JDanison/Block-P-Neon-Sign/Software/Images/Background/OregonBlockP.JPG

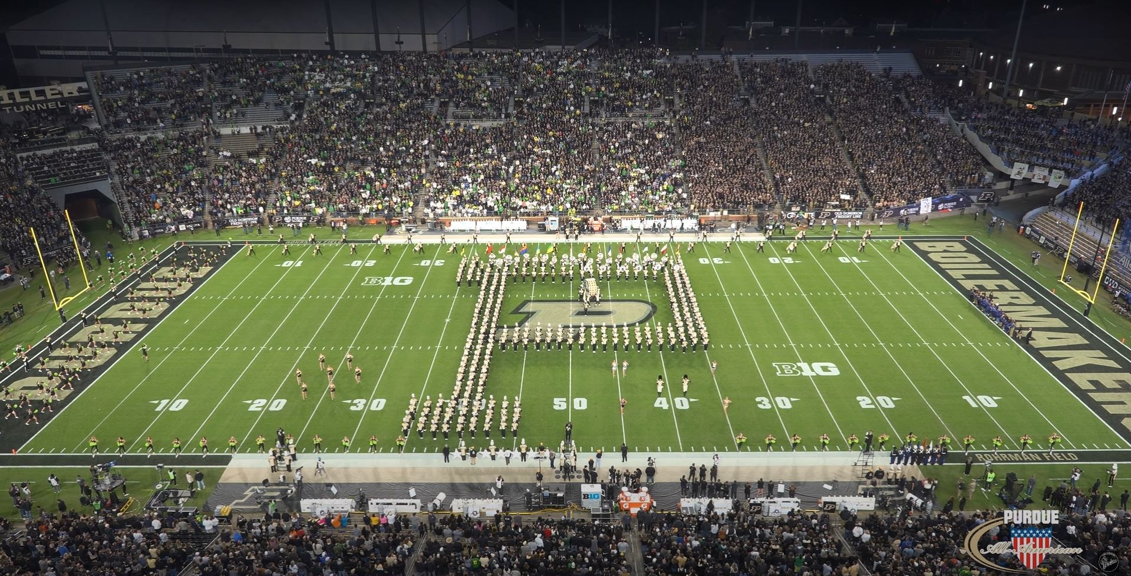
Software/Images/Background/OregonBlockP.JPG
