JDanison/Block-P-Neon-Sign/Hardware/CAD/block_p_viewer.html

# Block P CAD

The 8" build for the Bambu H2C, about 15.1 × 12.7 × 2.2 in. Pick Build guide above the model to see the assembly order. The LED strip is modeled as a standard 10 mm WS2812B until you confirm yours, and some other sizes are estimates until your parts arrive. Drag to rotate, scroll or use + and − to zoom, and right-drag to move.

Explore model Build guide: 12 steps

Loading the model…

Back Next

View

Zoom+−

LEDsOnOff

Explode Cut through depth

Show

## How the LEDs get power

Power reaches the strip at the inside corner where the stem meets the band under the screen. That corner has two 6 mm wire holes, and the bare wall there stays free of LEDs. Use the LED power view to see it from behind.

Hole | Wires | Goes to
Band side, 5 mm right of the corner | 5V, ground and data | Start of the strip, running right along the underside of the band
Stem side, 5 mm below the corner | 5V and ground only | Far end of the strip, after it has gone all the way around

Both ends get power so the far LEDs stay bright. The data wire connects only at the start. In the viewer, red is 5V, black is ground, green is data and orange is 12V.

## How the screen connects

The panel is 194 × 119 × 5 mm, and 11 mm with its rear circuit board. It sits rotated 180°, so its HDMI and power ports face down toward the Pi. Use the Screen wiring view to see it from behind.

Screen port | Cable | Comes from
HDMI | Flat HDMI ribbon | The Pi's micro-HDMI port beside the USB-C port (HDMI 0)
Power USB-C | USB-C power lead | The 5V junction
Touch USB-C | 1 ft right-angle USB cable | The Pi's upper USB 2.0 port

The speaker and button headers, audio jack and backlight switch stay unused. The picture and touch are rotated in software on the Pi.

## Wire bend check

Every corner in the model is a true arc, built at that cable's minimum bend radius. Route ends leave their connectors straight, then turn.

Route | Cable | Minimum (mm) | Tightest (mm) | Length (mm) | Status

## Parts to print

File | Filament | Size (mm) | Job
shell_upper | Black | 321 × 252 × 55 | Top of the sign, screen window, speaker pockets, vents
shell_lower | Black | 113 × 139 × 55 | Lower stem and foot, power jack
diffuser_upper | Translucent white | 321 × 252 × 17 | Glowing outline, glued over the LED channel
diffuser_lower | Translucent white | 113 × 139 × 17 | Same, for the lower section
cover_upper | Black | 315 × 275 × 24 | Back panel, wall keyholes, Pi and board mounts
cover_lower | Black | 107 × 109 × 8 | Back panel for the stem and foot
4 screen_clip files | Black | 33 × 16 × 4 | Hold the screen by its corners, leaving the cable paths open
stem_splice | Black | 25 × 40 × 4 | Joins the two shell sections inside the stem
audio_strap | Black | 48 × 12 × 3 | Holds the USB dongle in its cradle
pi_bracket_left, pi_bracket_low, pi_bracket_high | Black | 3 mm thick | Hold the Pi case by its top screw positions

Every piece fits the H2C, but the two upper sections are 321 mm wide, so print those on the left nozzle only, where the bed is 325 mm wide. The print files are already laid flat, and the whole sign uses up to about 910 g of filament at full infill, so far less at normal settings. Print the three test pieces in print/test_pieces first to check the diffuser fit, glow and screw hole size. For the smoothest face, print the shells face down on a smooth PEI plate.

## How it goes together

1. Cut the strip into 12 sections, one for each straight wall, and stick them to the channel wall. Solder short 3-wire jumpers across the 11 corners, following the arrows on the strip. The two ends finish at the wire holes beside the stem.
2. Join the shell sections with the stem splice and 4 M3 screws, and glue on the diffusers.
3. Hook each speaker's two front tabs under the pads, drivers facing the grille, then lower it onto the two rear posts and fit 2 M3 × 12 mm screws. Run a screwdriver in along the inside with the cover off. Do this before fitting the screen.
4. Set the screen in from behind, rotated 180° so its ports face down, and screw on the 4 corner clips. The picture is flipped back in software.
5. Assemble the Pi in its case, using the kit's extra brass spacers on top. Set it in its corner stops on the upper cover and fit the three brackets. Add the converter and level shifter. Set the USB dongle in its cradle, screw the strap over it, and connect it to the Pi with its short USB cable. Then route and zip-tie the wires.
6. Fit the power jack through the foot, connect everything and test it.
7. Screw on both covers. The upper cover bridges the shell joint for strength.
8. Hang it on 2 wall screws, 201 mm apart, using the keyholes.

## How it's designed

- Power cord: It enters through the bottom of the foot and hangs straight down the wall.
- Wires: They run up the stem, then along a channel above the speakers, behind the screen. Each route is checked as a 3 mm bundle.
- Speakers: Two rear screws and two front hooks hold each one. The grille sits about 9 mm below the speaker face, and a 16 mm gap between the speakers gives their cables room.
- Raspberry Pi: The N300 case has no mounting holes underneath, so three printed brackets hold it from its top spacers, with corner stops around the case. Its fins face the back cover vents.
- USB dongle: It has no mounting holes, so a low cradle and screwed strap hold it, with its 4-pin header facing the speakers.
- LEDs: 68 LEDs sit on the outer wall of a 10 mm deep channel, facing out, about 6 mm behind the diffuser. Each corner has room for a soldered jumper.
- Cooling: Cool air enters low, through the bottom of the foot, the stem walls, the underside and the lower right wall. It rises past the electronics and leaves through the top wall and upper side walls, so the airflow doesn't depend on the gap behind the sign.
- Servicing: The covers come off with screws, so the wiring stays reachable. The diffusers are glued on.

## Send when parts arrive

- Screen: exact port positions on the rear board. They're scaled from a photo
- Speakers, which you already have: length, width, thickness, tab hole size and spacing, and how far the tabs sit from the face
- Converter: length, width, thickness and mounting holes
- USB dongle, which you already have: total length, body length, width and thickness
- Power jack: hole size and thread
- LED strip: width, LEDs per meter, total length and thickness
- Pi in its case: length, width, thickness and top-of-USB height

## Small hardware

- 44 M3 × 10 mm self-tapping screws, the only screw size in the sign
- 10 small zip ties, 3.6 mm wide or narrower, for the 10 clips on the back cover
- 2 wall screws with heads under 9 mm, shafts under 5 mm
- Thin wire for 33 corner jumper wires, 3 at each of 11 corners. Stranded 24 AWG or thinner bends best, and the tight corner under the top-left notch needs 28 AWG
- 4 stick-on rubber bumpers, about 8 mm tall, to hold the back off the wall
- CA glue for the diffusers, plus thin foam tape for the dongle strap

## Files

All files are in Hardware/CAD in your project folder.

- print/black and print/white: STL files for Bambu Studio, sorted by filament color and already flat on the bed. print/PRINT_LIST.md lists every file
- step: exact CAD files for each part and the full assembly
- block_p_assembly_preview.stl: the whole assembled sign, for other model viewers
- block_p.py: the model itself. Every size is a named number at the top
