JDanison/Block-P-Neon-Sign/Design Process/Renders/block-p-renders.html

# Block P sign

All three sizes use your locked shape at true scale. Drag to rotate, scroll or pinch to zoom.

Loading the 3D model…

View

AngleFrontSideBelow

Zoom+−

LEDsGoldOff

RoomDimLit

PrintBlackWhite

Select 5", 7" or 8" to see that option's details, wiring and parts.

## Parts to buy

Part | Spec | Notes

## Power wiring

One cord comes in at 12V, and the converter inside the sign makes a steady 5V. The Pi and the LEDs each take their own branch, so the LEDs never draw through the Pi.

### Bring-up order

1. Check that the adapter is center positive, then connect the jack and converter.
2. Measure the converter output with nothing else connected. Expect about 5.0 to 5.25V.
3. Solder the 5V junction and the Pi's USB-C lead, then boot the Pi.
5. Play a video and run vcgencmd get_throttled. A result of 0x0 means no low-voltage events.
6. Add the strip's power at both ends and the capacitor, then the level shifter, resistor and data line.
7. Run everything together for a few hours before it goes in the enclosure.

### Estimated power, gold LEDs

Load | Amps at 5V | Basis

Audio assumes the board's 2.6W into 4Ω rating drops by about half with your 8Ω speakers. The LED figure uses the strip seller's 5V 3A per meter at gold brightness.

### Get back to this page

Open it from the pinned list in your claude.ai sidebar, or from /artifacts in Claude Code. The link and a saved copy are listed in PROGRESS.md in the project folder.
