JDanison/Block-P-Neon-Sign/Hardware/BOM.md

# Block P Sign: Bill of Materials

For the locked Block P shape with the 8" screen: about 15.4 x 12.6 x 2.2 in, black print, your own WS2812B strip (about 1.3 m in 12 sections).

Only the screen's details come from the maker. Other details are seller listings, so check each listing before buying.

## Buy

| Part | Spec | Notes |
|---|---|---|
| [Waveshare 8DP-CAPLCD 8" screen](https://www.amazon.com/dp/B0BPMCTQQ8) | 1280 x 800 HDMI | Includes HDMI, USB, micro-HDMI adapter and spacers |
| [Meiyue 12V 5A adapter](https://www.amazon.com/dp/B0BPSQ84TT) | 60W, 5.5 x 2.1 mm plug | About 5 ft cord. Check it is center positive |
| [Tugermoola barrel jacks, 6 sets](https://www.amazon.com/dp/B0DP6MNQQB) | 5.5 x 2.1 mm, panel mount | Uses 1 |
| [KNACRO 12V to 5V converter](https://www.amazon.com/dp/B07D268SDY) | 10A, 50W | Size the mount from the real part |
| [Vovucai USB-C power leads, 5 pack](https://www.amazon.com/dp/B0F31YX6XX) | 22 AWG, 5V 3A | Uses 2. Cut to about 30 cm |
| [SN74AHCT125N, 5 pack](https://www.amazon.com/dp/B08FHD994N) | 3.3V to 5V level shifter | Skip if you have one |
| [chenyang flat HDMI to micro-HDMI cable](https://www.amazon.com/dp/B01367WEI4) | 0.2 m, 90 degree up | Buy after CAD confirms the direction |
| [SUNGUY right angle USB-A to C cables, 2 pack, 1 ft](https://www.amazon.com/dp/B0784F9JP2) | 1 ft, supports data | For touch. The 6 in version does not reach |
| [Geekworm N300 heatsink case](https://www.amazon.com/dp/B07X5Y81C6) | 16 mm thick, for Pi 4 | Cools the Pi with no fan |
| [Glvaner M3 x 10 mm self-tapping screws, 100 pack](https://www.amazon.com/dp/B09NPL4P9W) | 304 stainless steel, pan washer head | Uses 44 |
| [PATIKIL perfboard, 24 pack](https://www.amazon.com/dp/B0CBPRBRTT) | 1.2 x 1.2 in | Holds the level shifter |
| [eSUN Lithophane White PLA+, 1 kg](https://www.amazon.com/dp/B0D7PZS1VV) | LED diffuser | Translucent white. Test with your strip first |

## Optional

| Part | Spec | Notes |
|---|---|---|
| [YUNPICAR fuse holders, 2 pack](https://www.amazon.com/dp/B09539L14T) | 18 AWG, with 5A mini blade fuses | LED branch, recommended |
| [Fancasee DC extension cord](https://www.amazon.com/dp/B09SZ88S1Y) | 6 ft, 18 AWG, 5.5 x 2.1 mm | If the 5 ft cord falls short. Check that it is rated for 3A or more |
| [FCOB WS2812B strip, 6.56 ft](https://www.amazon.com/dp/B0FL7GKGVM) | 5V, 160 LEDs/m, 5 mm wide | Only if your own strip is too short. The CAD would need updating |

## Small hardware

Needed for the current CAD model, if you don't already have them.

- 10 small zip ties, 3.6 mm wide or narrower
- 2 wall screws with heads under 9 mm and shafts under 5 mm
- 4 stick-on rubber bumpers, about 8 mm tall
- CA glue and thin foam tape
- Thin wire for 33 corner jumper wires

## Already owned

Raspberry Pi 4B, microSD card, WS2812B LED strip, Waveshare USB to Audio dongle and its short USB extension cable, QCCAN 8 ohm 5W speakers (about 100 x 45 x 21 mm, holes 92 x 36 mm, mounted under the screen firing down), wire, heat shrink, resistor, capacitor, multimeter, black filament, soldering gear and a Bambu printer.
