JDanison/Block-P-Neon-Sign/Hardware/CAD/block_p_assembly_preview.stl

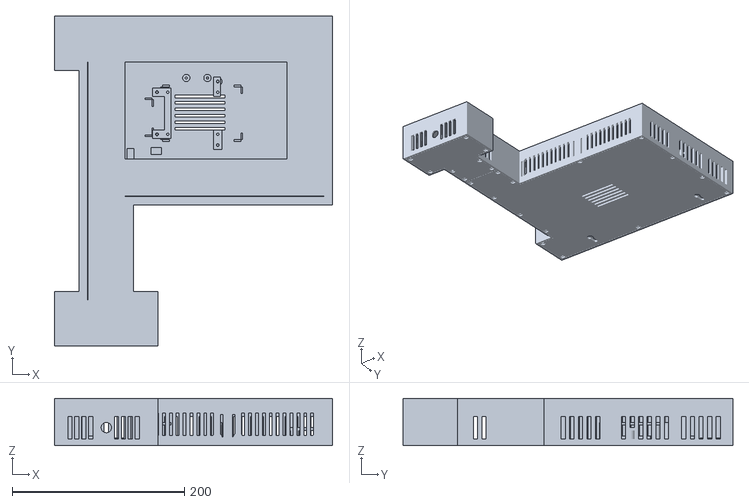
[picture p2: CAD file, 2026-11-02]
Hardware/CAD/block_p_assembly_preview.stl
322.7 x 382.8 x 55.0
