JDanison/Block-P-Neon-Sign/Hardware/CAD_v1_saved/block_p_assembly_preview.stl

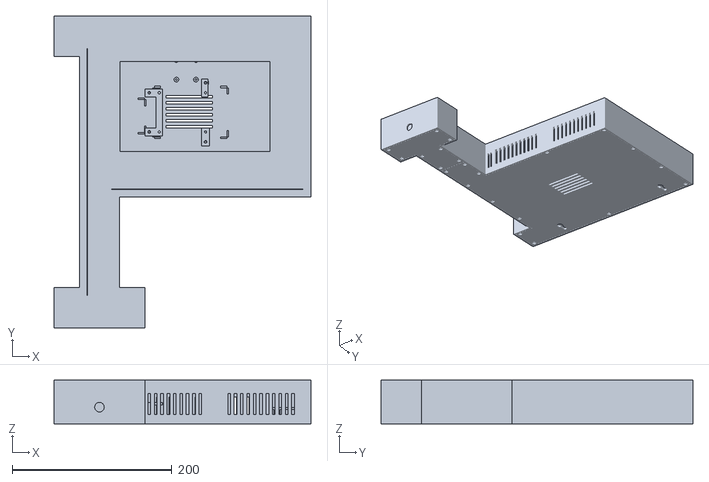
[picture p3: CAD file, 2026-11-02]
Hardware/CAD_v1_saved/block_p_assembly_preview.stl
321.3 x 390.6 x 55.0
