JDanison/Block-P-Neon-Sign/Hardware/CAD/print/black/BLACK_cover_upper.stl

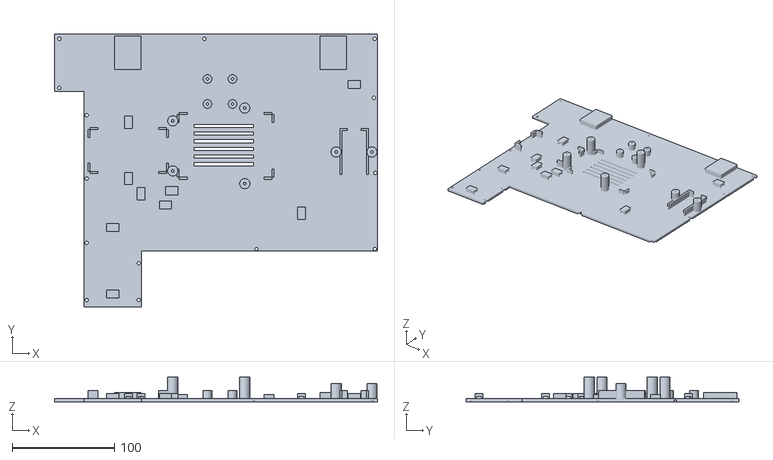
[picture p4: CAD file, 2026-11-02]
Hardware/CAD/print/black/BLACK_cover_upper.stl
316.3 x 267.5 x 24.0
