JDanison/Block-P-Neon-Sign/Hardware/CAD/print/test_pieces/BLACK_test_body_corner.stl

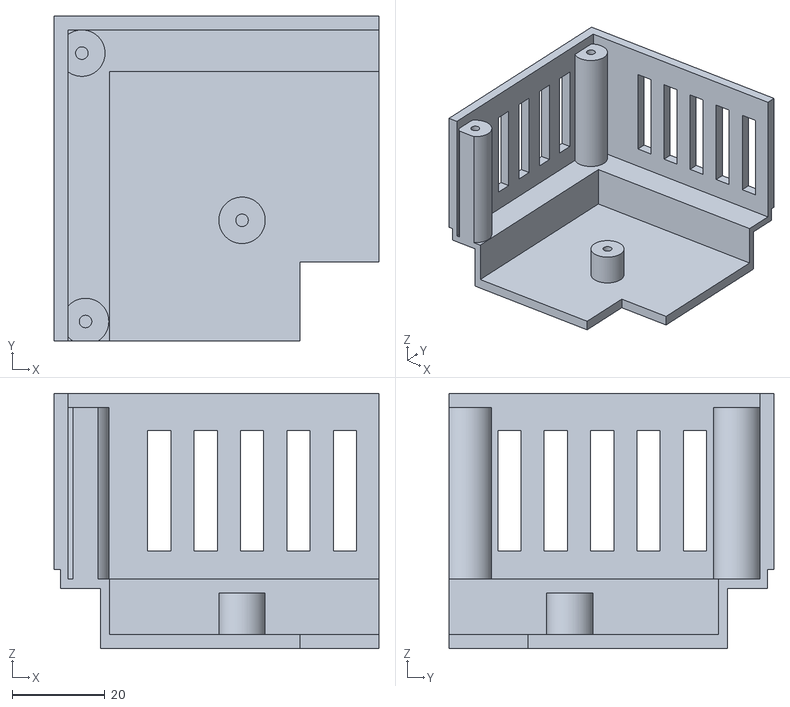
[picture p5: CAD file, 2026-11-02]
Hardware/CAD/print/test_pieces/BLACK_test_body_corner.stl
70.0 x 70.0 x 55.0
