JDanison/Block-P-Neon-Sign/Hardware/CAD/print/white/WHITE_diffuser_lower.stl

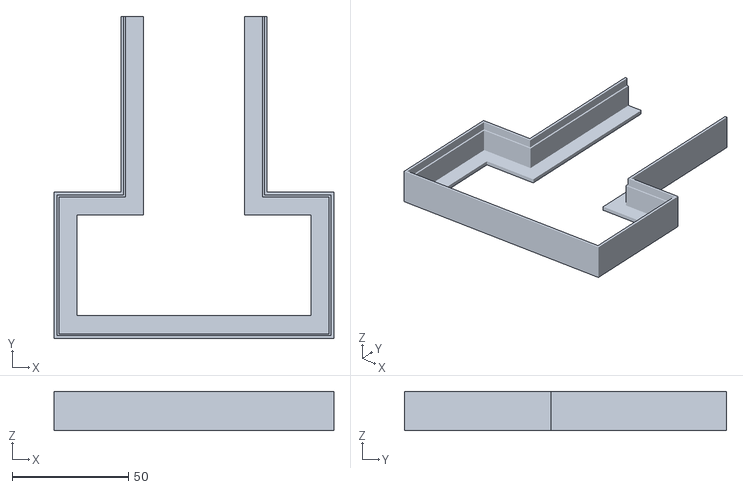
[picture p6: CAD file, 2026-11-02]
Hardware/CAD/print/white/WHITE_diffuser_lower.stl
120.3 x 138.6 x 17.0
