JDanison/Block-P-Neon-Sign/Hardware/CAD/step/diffuser_upper.step

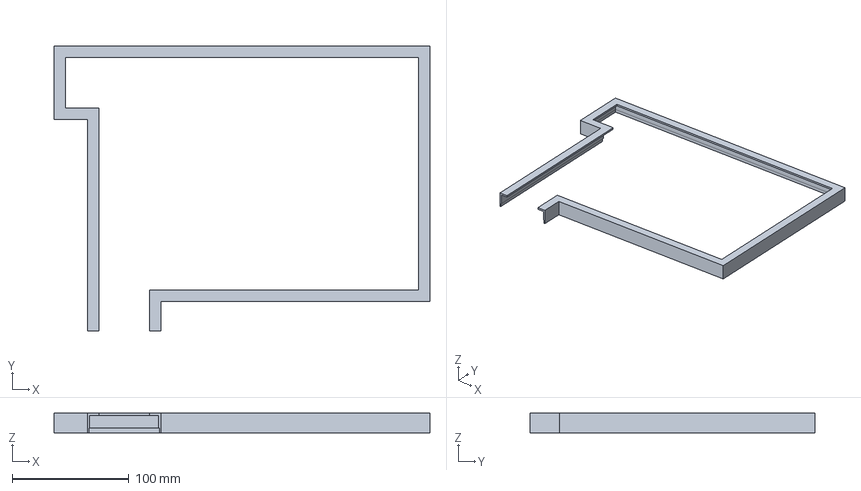
[picture p7: CAD file, 2026-11-02]
Hardware/CAD/step/diffuser_upper.step
322.7 x 244.2 x 17.0 mm
