JDanison/Block-P-Neon-Sign/Hardware/CAD_v1_saved/print/test_pieces/test_body_corner.stl

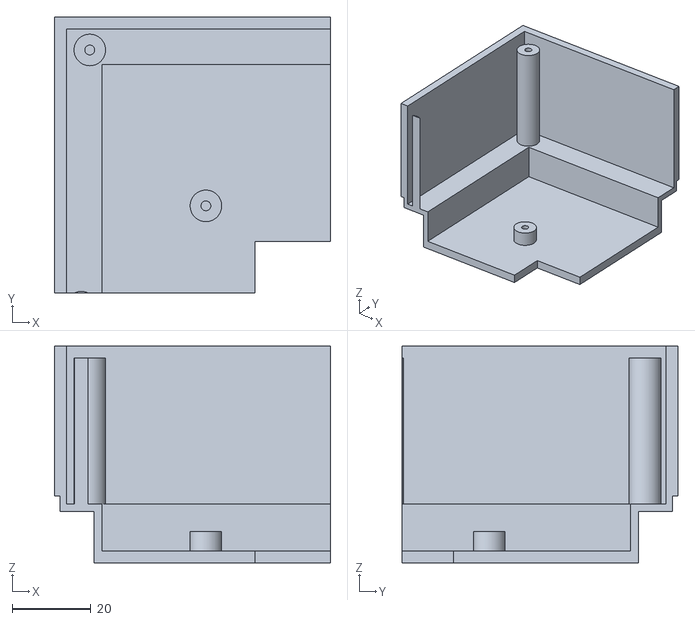
[picture p8: CAD file, 2026-11-02]
Hardware/CAD_v1_saved/print/test_pieces/test_body_corner.stl
70.0 x 70.0 x 55.0
