JDanison/Block-P-Neon-Sign/Hardware/CAD_v1_saved/step/stem_splice.step

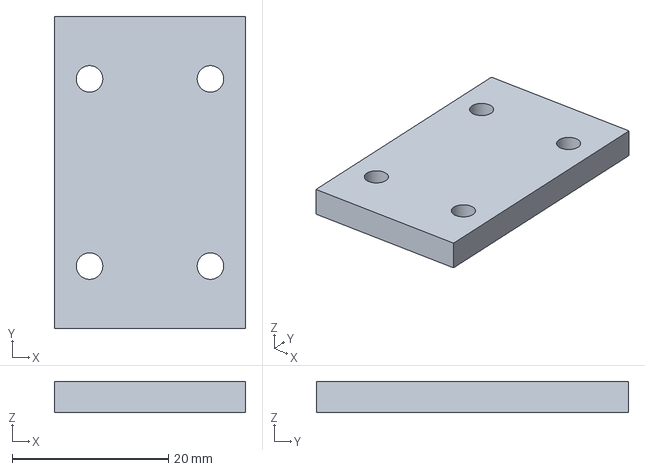
[picture p9: CAD file, 2026-11-02]
Hardware/CAD_v1_saved/step/stem_splice.step
24.5 x 40.0 x 4.00 mm
