JDanison/Block-P-Neon-Sign/Hardware/CAD/print/black/BLACK_audio_strap.stl

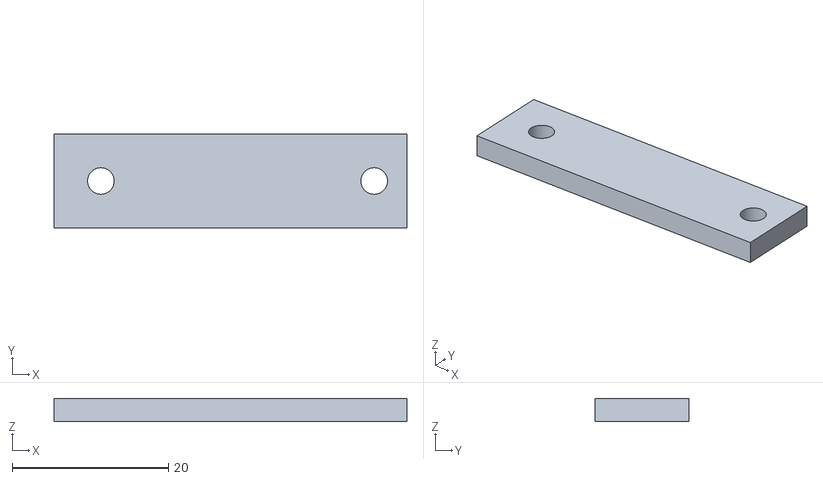
[picture p10: CAD file, 2026-11-02]
Hardware/CAD/print/black/BLACK_audio_strap.stl
45.2 x 12.0 x 3.00
