JDanison/Block-P-Neon-Sign/Hardware/CAD/step/pi_bracket_high.step

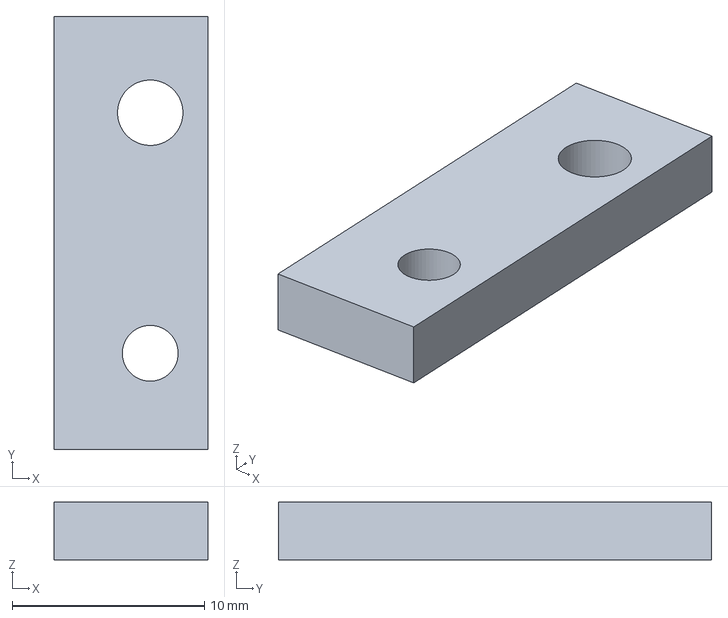
[picture p11: CAD file, 2026-11-02]
Hardware/CAD/step/pi_bracket_high.step
8.00 x 22.5 x 3.00 mm
