JDanison/Block-P-Neon-Sign/Hardware/CAD_v1_saved/print/test_pieces/test_diffuser_corner.stl

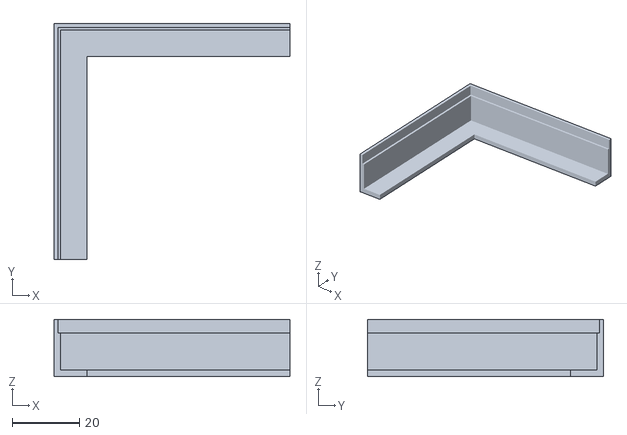
[picture p12: CAD file, 2026-11-02]
Hardware/CAD_v1_saved/print/test_pieces/test_diffuser_corner.stl
70.0 x 70.0 x 17.0
