JDanison/Block-P-Neon-Sign/Hardware/CAD/print/black/BLACK_screen_clip_top_left.stl

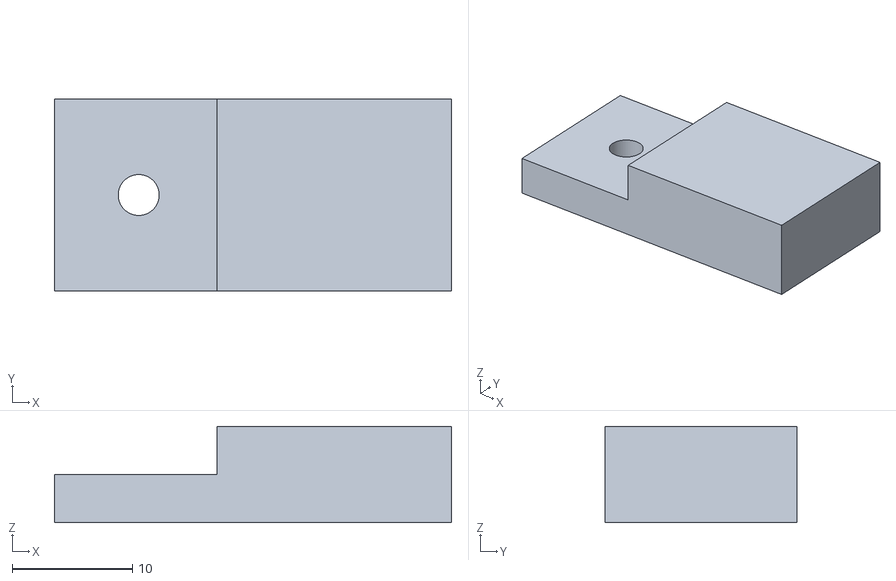
[picture p13: CAD file, 2026-11-02]
Hardware/CAD/print/black/BLACK_screen_clip_top_left.stl
33.0 x 16.0 x 8.00
