JDanison/Block-P-Neon-Sign/Hardware/CAD_v1_saved/step/cover_upper.step

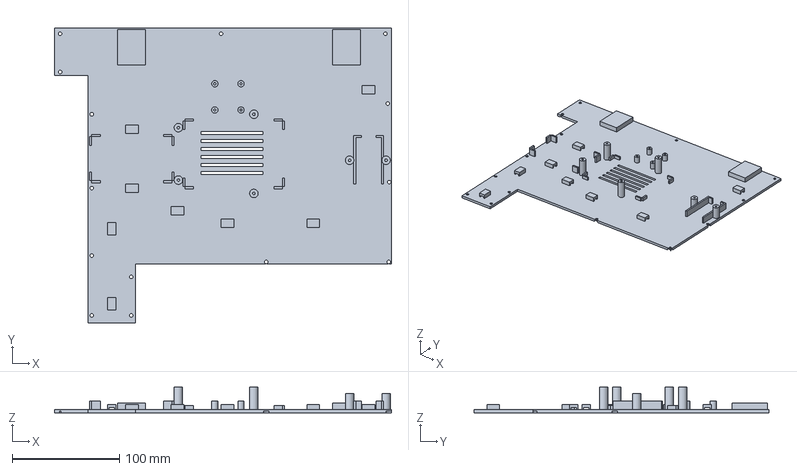
[picture p14: CAD file, 2026-11-02]
Hardware/CAD_v1_saved/step/cover_upper.step
314.9 x 275.2 x 24.0 mm
