JDanison/Block-P-Neon-Sign/Hardware/CAD/print/black/BLACK_shell_lower.stl

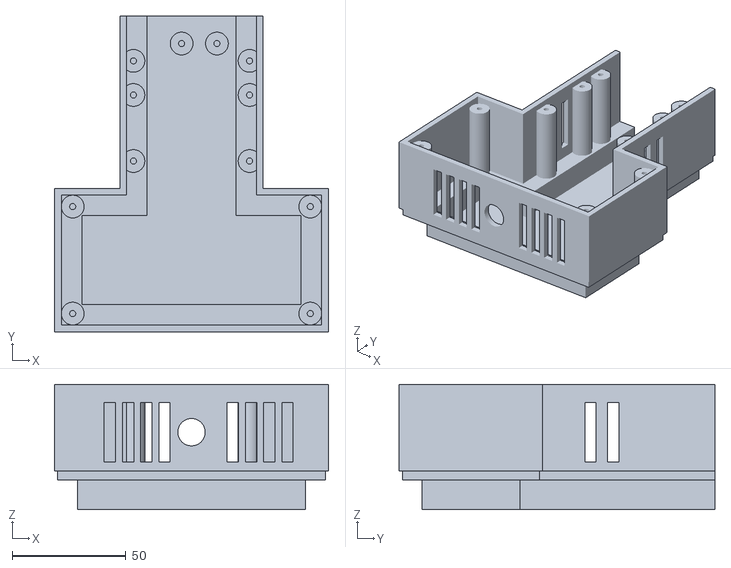
[picture p15: CAD file, 2026-11-02]
Hardware/CAD/print/black/BLACK_shell_lower.stl
120.3 x 138.6 x 55.0
