JDanison/Block-P-Neon-Sign/Hardware/CAD/step/pi_bracket_left.step

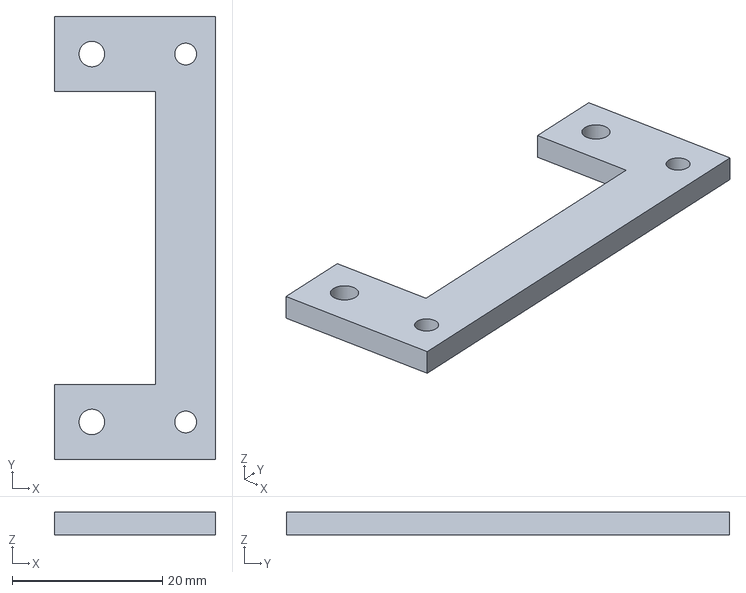
[picture p17: CAD file, 2026-11-02]
Hardware/CAD/step/pi_bracket_left.step
21.5 x 59.0 x 3.00 mm
