JDanison/Block-P-Neon-Sign/Hardware/CAD/print/black/BLACK_shell_upper.stl

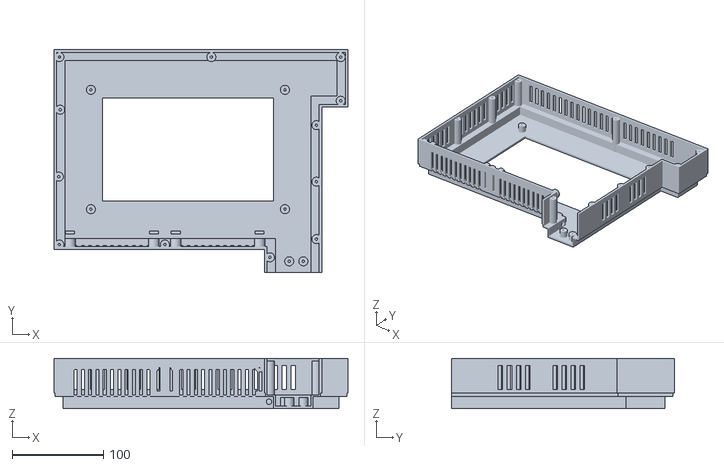
[picture p18: CAD file, 2026-11-02]
Hardware/CAD/print/black/BLACK_shell_upper.stl
322.7 x 244.2 x 55.0
