JDanison/Block-P-Neon-Sign/Hardware/CAD/step/pi_bracket_low.step

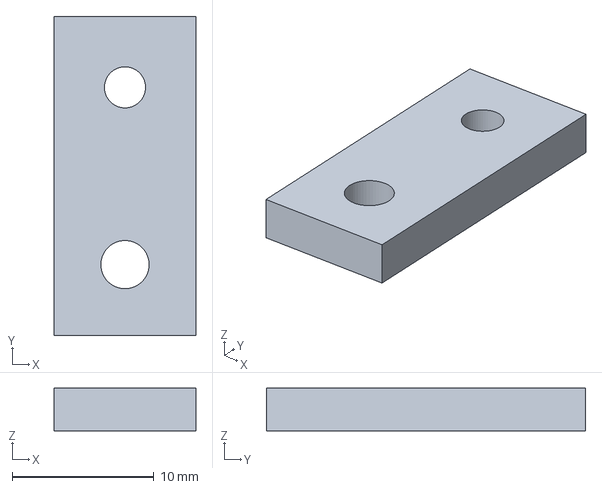
[picture p19: CAD file, 2026-11-02]
Hardware/CAD/step/pi_bracket_low.step
10.0 x 22.5 x 3.00 mm
