JDanison/Block-P-Neon-Sign/Hardware/CAD_v1_saved/step/screen_clip_top_left.step

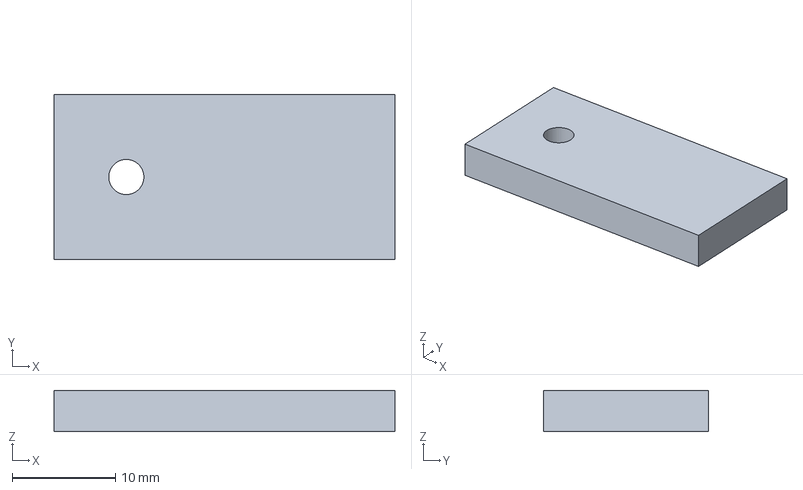
[picture p20: CAD file, 2026-11-02]
Hardware/CAD_v1_saved/step/screen_clip_top_left.step
33.0 x 16.0 x 4.00 mm
