JDanison/Block-P-Neon-Sign/Hardware/CAD/print/black/BLACK_cover_lower.stl

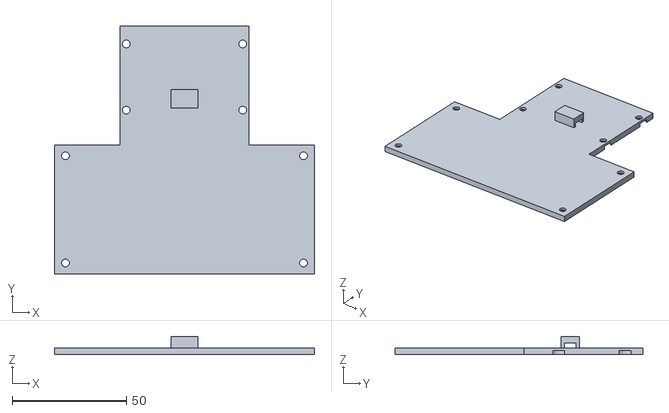
[picture p21: CAD file, 2026-11-02]
Hardware/CAD/print/black/BLACK_cover_lower.stl
113.9 x 108.7 x 8.00
