JDanison/Block-P-Neon-Sign/Hardware/CAD_v1_saved/step/cover_lower.step

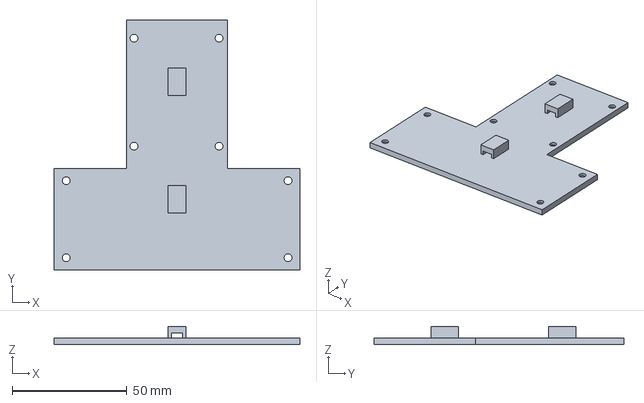
[picture p22: CAD file, 2026-11-02]
Hardware/CAD_v1_saved/step/cover_lower.step
107.0 x 108.6 x 8.00 mm
