JDanison/Block-P-Neon-Sign/Hardware/CAD_v1_saved/step/shell_upper.step

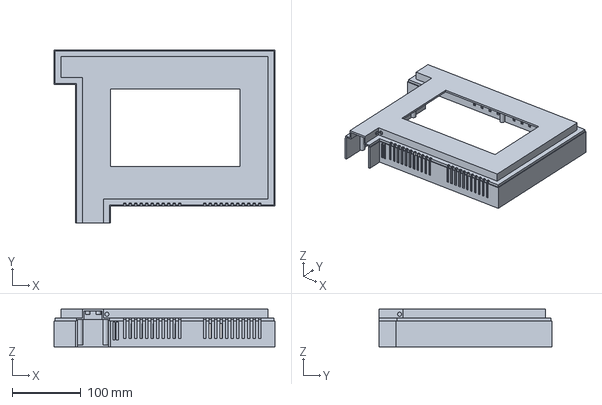
[picture p23: CAD file, 2026-11-02]
Hardware/CAD_v1_saved/step/shell_upper.step
321.3 x 252.0 x 55.0 mm
