JDanison/Block-P-Neon-Sign/Hardware/CAD_v1_saved/step/diffuser_lower.step

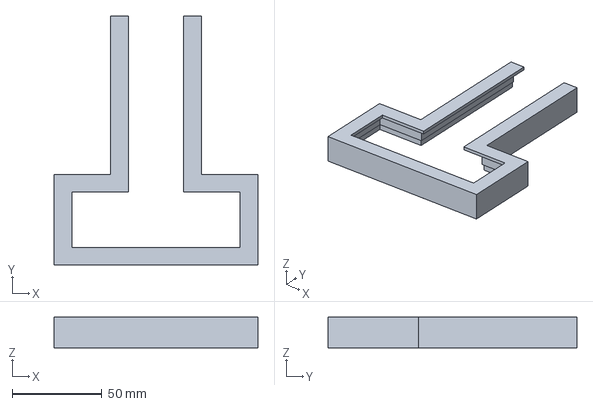
[picture p24: CAD file, 2026-11-02]
Hardware/CAD_v1_saved/step/diffuser_lower.step
113.4 x 138.6 x 17.0 mm
