JDanison/Block-P-Neon-Sign/Hardware/CAD_v1_saved/step/audio_strap.step

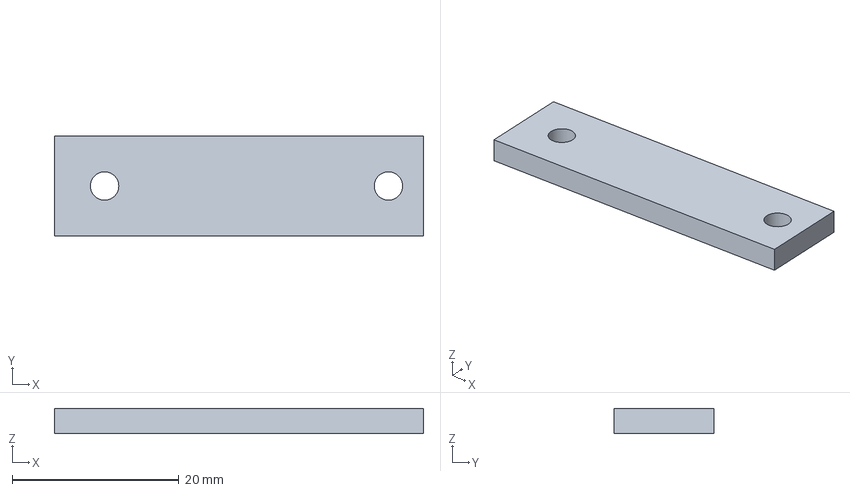
[picture p25: CAD file, 2026-11-02]
Hardware/CAD_v1_saved/step/audio_strap.step
44.2 x 12.0 x 3.00 mm
