JDanison/Block-P-Neon-Sign/Hardware/CAD_v1_saved/step/shell_lower.step

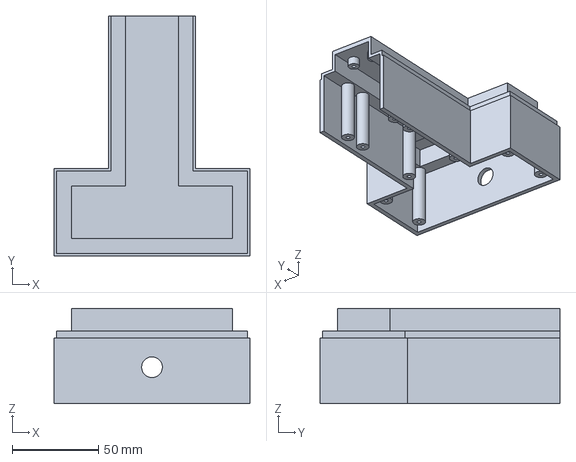
[picture p26: CAD file, 2026-11-02]
Hardware/CAD_v1_saved/step/shell_lower.step
113.4 x 138.6 x 55.0 mm
