JDanison/Block-P-Neon-Sign/(list of files, cad)

Other CAD files:
Hardware/CAD/step/block_p_assembly.step
Hardware/CAD_v1_saved/step/block_p_assembly.step
Hardware/CAD/print/white/WHITE_diffuser_upper.stl
Hardware/CAD_v1_saved/step/pi_bracket_high.step
Hardware/CAD/print/test_pieces/WHITE_test_diffuser_corner.stl
Hardware/CAD/step/stem_splice.step
Hardware/CAD/print/black/BLACK_screen_clip_bottom_right.stl
Hardware/CAD/step/screen_clip_bottom_left.step
Hardware/CAD_v1_saved/step/screen_clip_top_right.step
Hardware/CAD/print/black/BLACK_stem_splice.stl
Hardware/CAD/step/cover_lower.step
Hardware/CAD/print/black/BLACK_pi_bracket_left.stl
Hardware/CAD/step/diffuser_lower.step
Hardware/CAD/step/cover_upper.step
Hardware/CAD_v1_saved/step/pi_bracket_low.step
Hardware/CAD/step/screen_clip_top_right.step
Hardware/CAD/step/screen_clip_top_left.step
Hardware/CAD_v1_saved/step/screen_clip_bottom_right.step
Hardware/CAD/step/screen_clip_bottom_right.step
Hardware/CAD/step/shell_lower.step
Hardware/CAD_v1_saved/step/pi_bracket_left.step
Hardware/CAD/step/audio_strap.step
Hardware/CAD_v1_saved/step/screen_clip_bottom_left.step
Hardware/CAD/step/shell_upper.step
Hardware/CAD/print/test_pieces/BLACK_test_screw_holes.stl
Hardware/CAD_v1_saved/print/cover_lower.stl
Hardware/CAD_v1_saved/print/cover_upper.stl
Hardware/CAD_v1_saved/print/diffuser_lower.stl
Hardware/CAD_v1_saved/print/pi_bracket_high.stl
Hardware/CAD_v1_saved/print/pi_bracket_low.stl
Hardware/CAD_v1_saved/print/shell_lower.stl
Hardware/CAD_v1_saved/print/shell_upper.stl
