JDanison/Block-P-Neon-Sign/Software/ssh instructions.txt

RPi Login
Username:
pi or root

Password:
raspberry

ssh command
ssh pi@raspberrypi.local

keys located at ~/.ssh/known_hosts
Remove with rm
