JDanison/Block-P-Neon-Sign/Hardware/CAD/print/PRINT_LIST.md

# Block P Print List

Drag these STL files into Bambu Studio. They're already laid flat, and each filename starts with its filament color.

The model still uses estimated sizes for several parts, so print the test pieces first and wait to print the full sign until your parts are measured.

## Print first: `test_pieces`

| File | Filament |
|---|---|
| `BLACK_test_body_corner.stl` | Black |
| `WHITE_test_diffuser_corner.stl` | Translucent white |
| `BLACK_test_screw_holes.stl` | Black. Its three holes are 2.6, 2.7 and 2.8 mm, left to right. Try a screw in each to find the best fit |

## Black filament: `black`

| File | Qty | What it is | Notes |
|---|---:|---|---|
| `BLACK_shell_upper.stl` | 1 | Top of the sign | Left nozzle only. Use a smooth plate for a smooth face |
| `BLACK_shell_lower.stl` | 1 | Lower stem and foot | Use a smooth plate for a smooth face |
| `BLACK_cover_upper.stl` | 1 | Back cover, upper | Left nozzle only |
| `BLACK_cover_lower.stl` | 1 | Back cover, lower | |
| `BLACK_screen_clip_top_left.stl` | 1 | Screen clip | |
| `BLACK_screen_clip_top_right.stl` | 1 | Screen clip | |
| `BLACK_screen_clip_bottom_left.stl` | 1 | Screen clip | |
| `BLACK_screen_clip_bottom_right.stl` | 1 | Screen clip | |
| `BLACK_stem_splice.stl` | 1 | Joins the two shell sections | |
| `BLACK_audio_strap.stl` | 1 | Holds the USB audio dongle | |
| `BLACK_pi_bracket_left.stl` | 1 | Pi case bracket | |
| `BLACK_pi_bracket_low.stl` | 1 | Pi case bracket | |
| `BLACK_pi_bracket_high.stl` | 1 | Pi case bracket | |

## Translucent white filament: `white`

| File | Qty | What it is | Notes |
|---|---:|---|---|
| `WHITE_diffuser_upper.stl` | 1 | Glowing outline, upper | Left nozzle only |
| `WHITE_diffuser_lower.stl` | 1 | Glowing outline, lower | |
