JDanison/Block-P-Neon-Sign/Design Process/Design Parameters.pdf

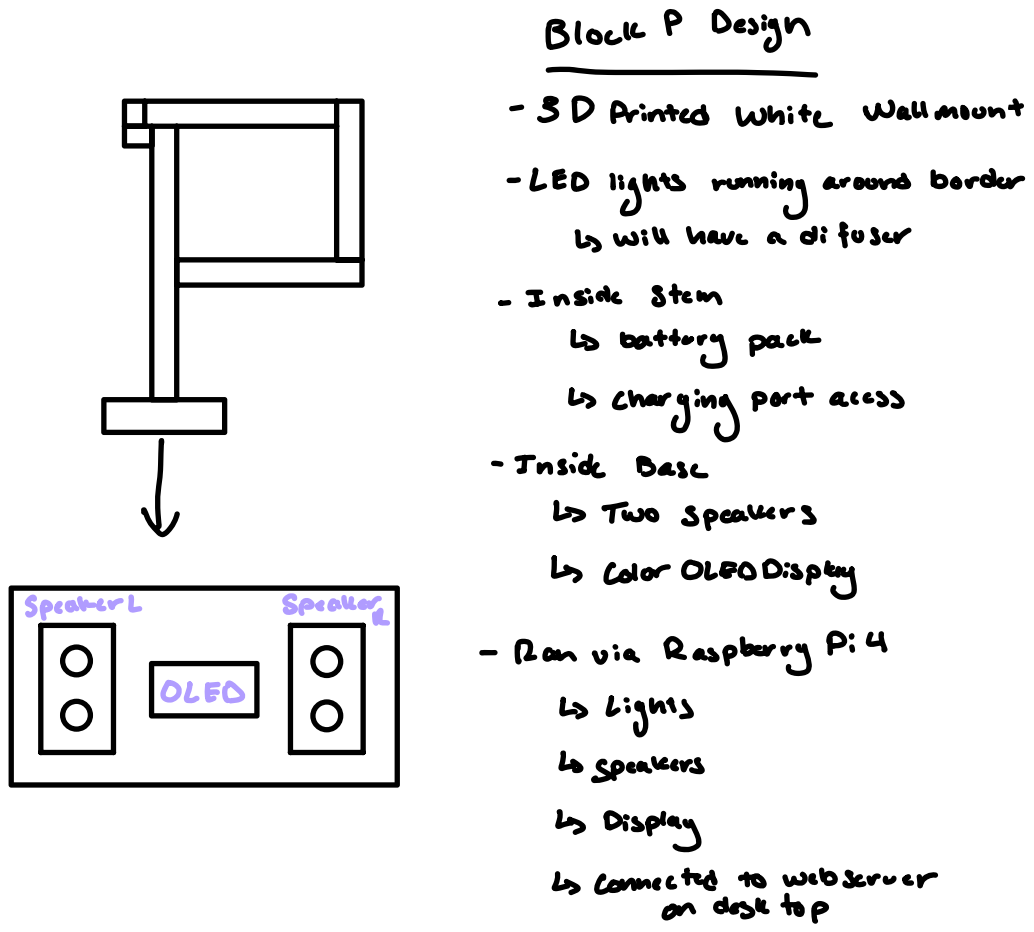
[picture p27: page 1]
iiiiiiie; EEjgit m; Ew p cancers; some; OLED; iiiiis
