JDanison/Block-P-Neon-Sign/Software/Dev Testing/Light Strip/print_message.py

# Simple script to print a message to the terminal
def main():
    print("Hello World!")
    print("This is a simple Python script running on the Raspberry Pi.")
    print("Keep that Purdue Grit!")

if __name__ == "__main__":
    main()
