JDanison/Block-P-Neon-Sign/(commit log)

2024-12-17 Adding Documentation and LED python sequence
2024-12-18 LED Lights Working and Changes
2024-12-20 Fixed Gold Shimmer Sequence
    [goldshimmer.py, lightsequencetesting.py]
2024-12-20 Added LED Control Instructions
2026-11-01 Add design decisions, BOM, renders and progress notes
2026-11-02 Add Block P CAD model, build guide and print files
    Add the parametric CAD model with collision, bend radius, front face and
    clip checks, a viewer with a 12 step build guide, and print files sorted
    by filament color. Keep a frozen v1 copy and update the parts list.
2026-11-02 Add chimney vents and widen the stem and foot
    Add low inlets and high outlets with a vent area check, widen the stem
    and foot by 10 mm, keep the foot at 9:4, and recenter the screen.
2026-11-02 Match formation proportions and strengthen screw posts
    Rebuild the outline from the band's formation counts, set by the printer
    bed, and check them on every rebuild. Thicken every screw post for M3
    self-tapping screws and add a pilot hole test piece.
